UltimaCodes/salt-sentinel/larp.jpeg

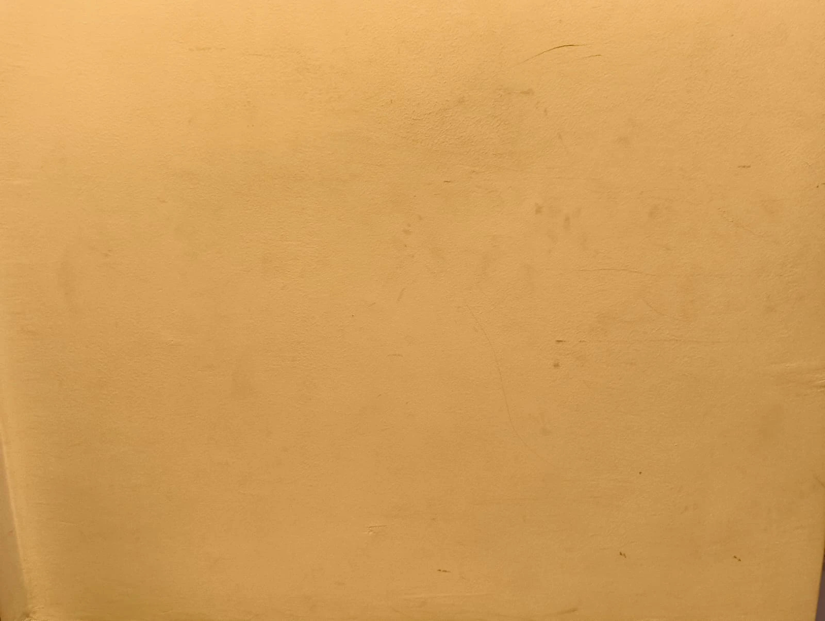
larp.jpeg
