UltimaCodes/salt-sentinel/TRELLO_CHECKLIST.txt

=======================================================
SALT SENTINEL - CHECKLIST  (rev 3 - post-build)
04 Sep  nationals
Paste each block into Trello as a list; one line = one card
=======================================================

Build and submission are done - this file only carries what's still ahead
of nationals. The full build-phase history (power tree, drivetrain,
sensor bring-up, calibration, validation wall) has been dropped; ask if
you need it back for the report's "challenges faced" section.

### PACK AND TRAVEL - WED 02 - THU 03 SEP ###
Build padded transport case for Lahore
Label every connector
Pack spares - motor, driver, ESP32, sensors, 3 spare cells, fuses
Print the report and any booth materials
Rehearse Q&A - be ready to answer AI usage questions out loud
Travel to Lahore

### DO NOT REGRESS ON - REFERENCE CARD ###
Never propose contact-based sensing - C1 is non-negotiable
Do not re-add EMI sensing - dry salt is non-conductive, specificity not earliness
Ultrasonic only for close-range standoff, never for mapping
Do not present [E] estimates as data
Standoff CONSISTENCY matters more than closeness
Dawn patrols, not midday - thermal signal inverts on sun-baked walls
Tag every reading with pass mode, conditions, dew point margin, dust flag
Thermal pass at ~1m so the frame has a dry reference, camera pass at ~25cm
LEDs fire one at a time, always
Never re-run calib-camera between visits
