UltimaCodes/salt-sentinel/schematics_final/salt_sentinel.pdf

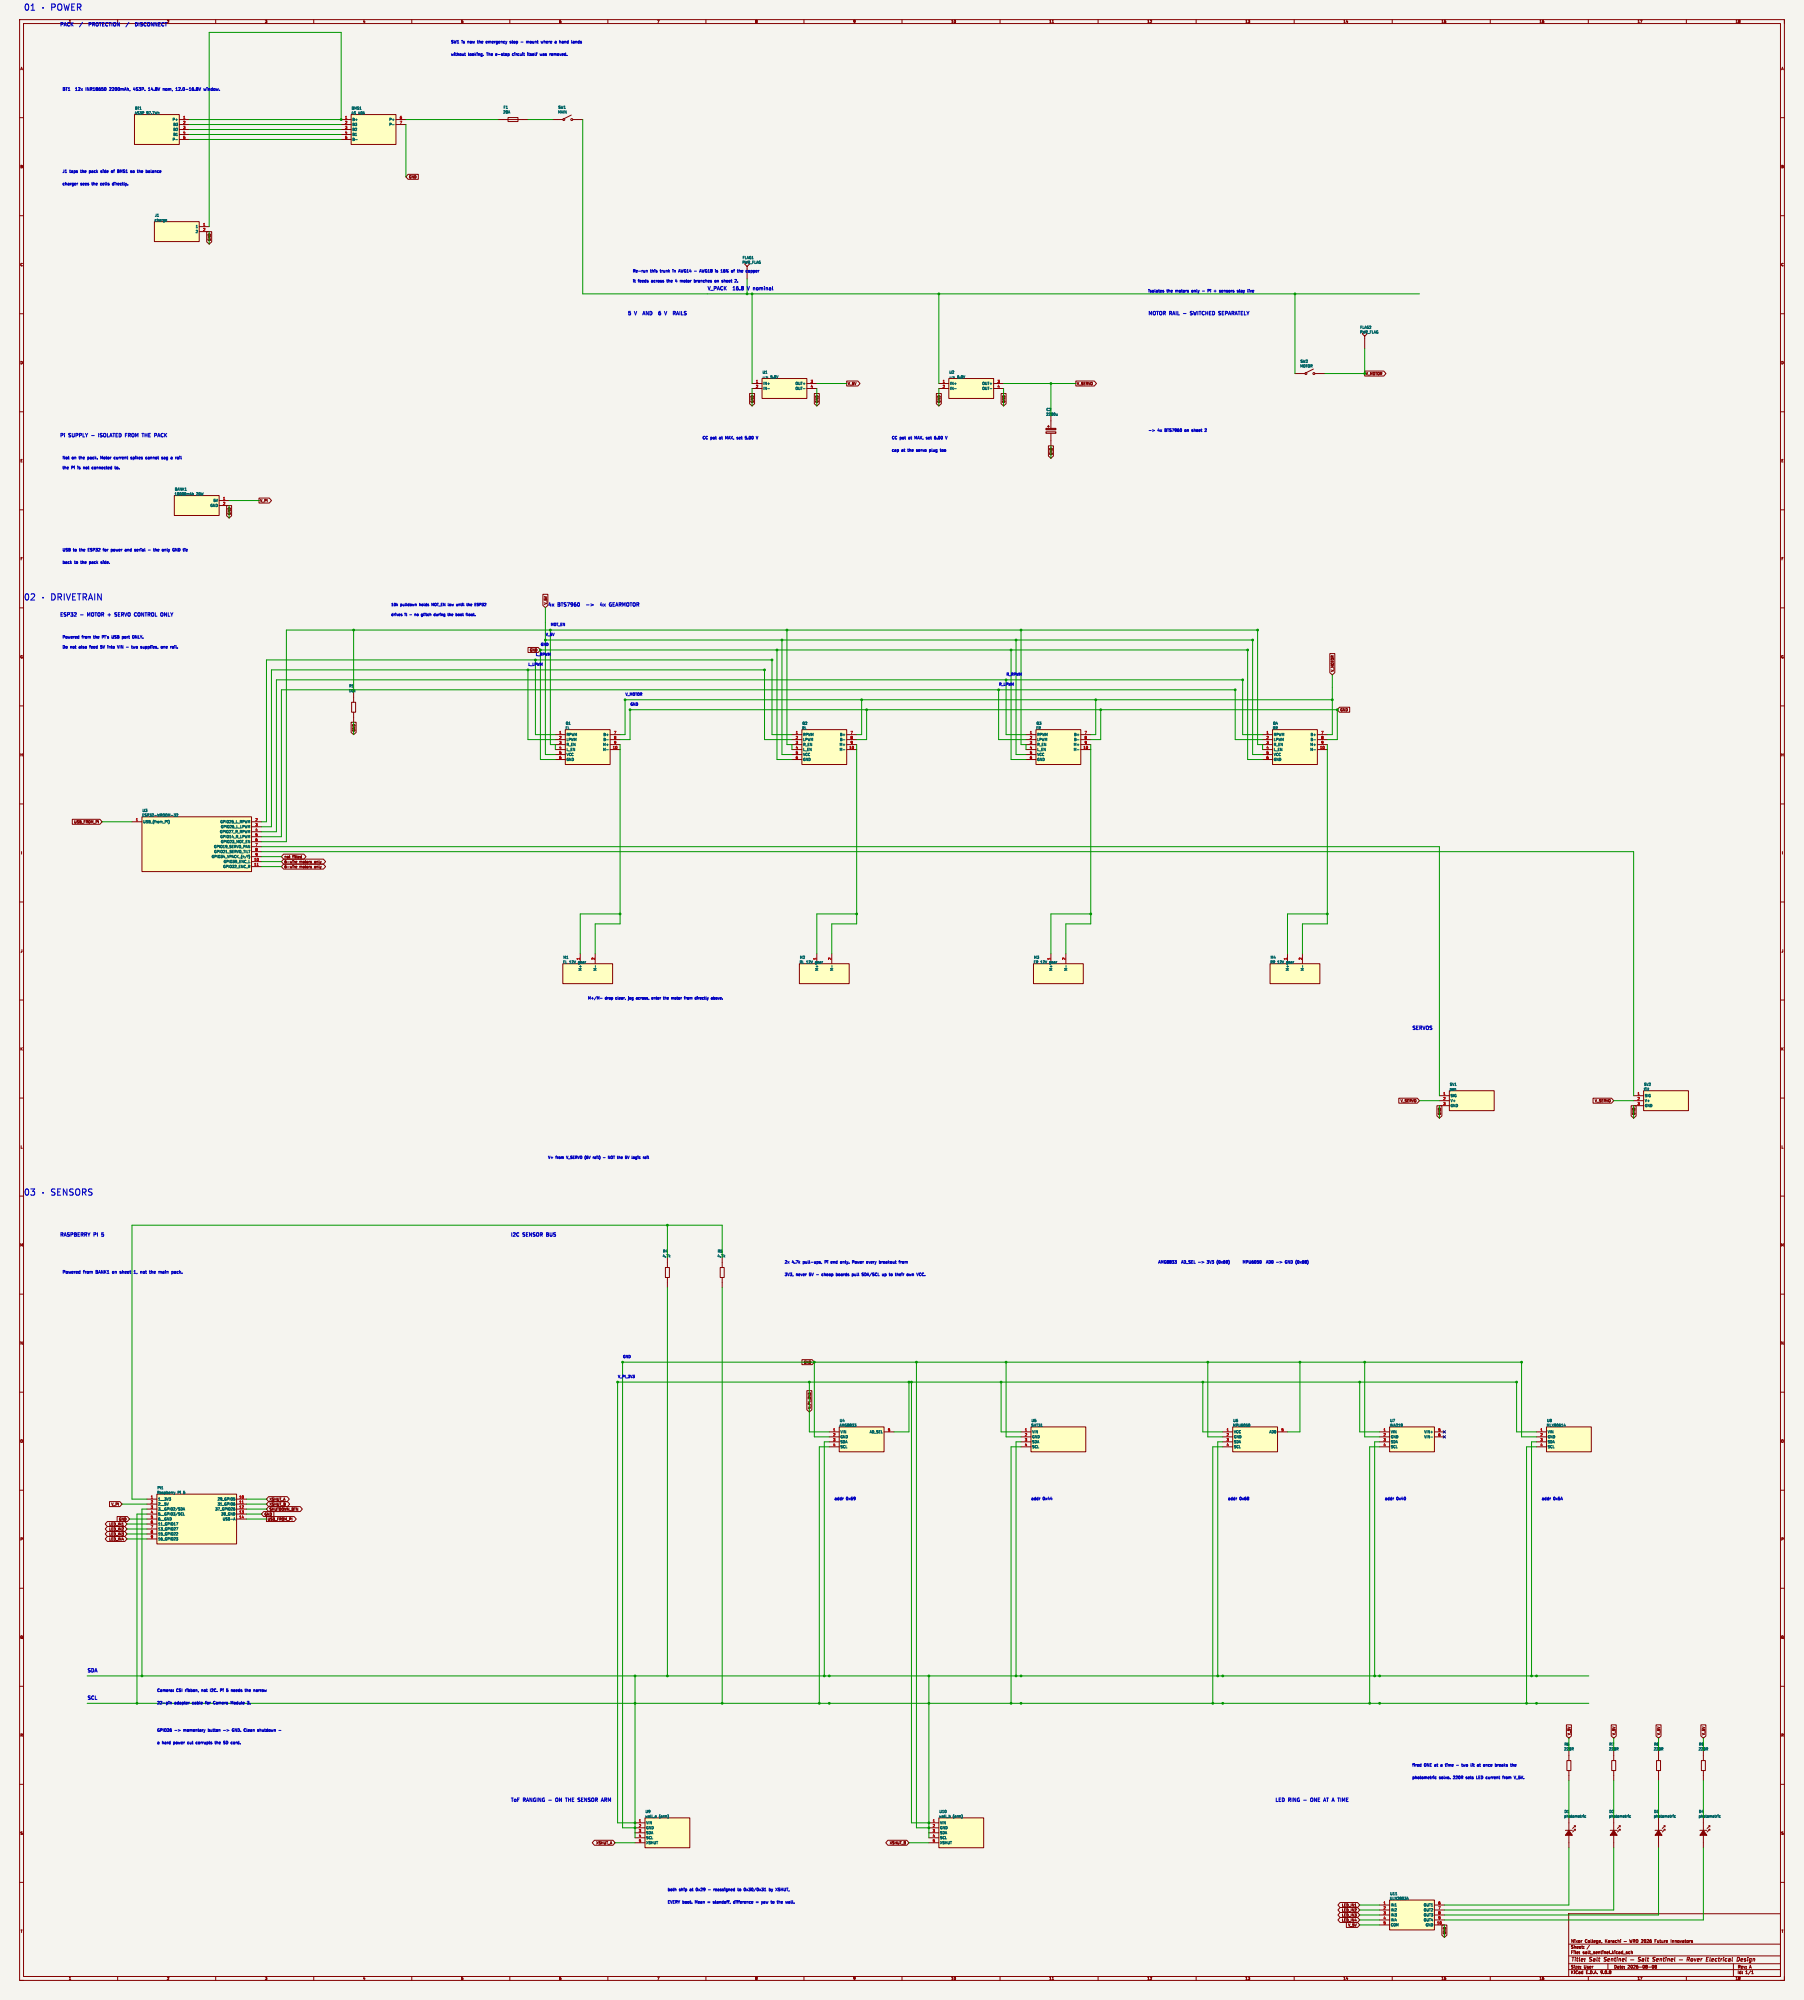
[picture p2: page 1]

J1 taps the pack side of BMS1 so the balance

charger sees the cells directly.

MOTOR RAIL - SWITCHED SEPARATELY

Pi SUPPLY - ISOLATED FROM THE PACK

CC pot at MAX, set 5.00 V

cap at the servo plug too CC pot at MAX, set 6.00 V

USB to the ESP32 for power and serial - the only GND tie

back to the pack side.

ESP32 - MOTOR + SERVO CONTROL ONLY

Powered from the Pi's USB port ONLY.

3V3, never 5V - cheap boards pull SDA/SCL up to their own VCC. V+ from V_SERVO (6V rail) - NOT the 5V logic rail

Camera: CSI ribbon, not I2C. Pi 5 needs the narrow

fired ONE at a time - two lit at once breaks the

LED RING - ONE AT A TIME

Id: 1/1 Title: Salt Sentinel þÿ Salt Sentinel þÿ Rover Electrical Design
