UltimaCodes/salt-sentinel/schematics_final/salt_sentinel.kicad_sch

## KiCad design schematics_final/salt_sentinel.kicad_sch (2026-08-31)

Schematic: salt_sentinel.kicad_sch

Parts:
BANK1: 10000mAh 20W
BMS1: 4S 40A
BT1: 4S3P 97.7Wh
C2: 2200u
D1, D2, D3, D4: photometric
F1: 20A
FLAG1, FLAG2: PWR_FLAG
J1: charge
M1: FL 12V gear
M2: RL 12V gear
M3: FR 12V gear
M4: RR 12V gear
PI1: Raspberry Pi 5
Q1: FL
Q2: RL
Q3: FR
Q4: RR
R1: 10k
R4, R5: 4.7k
R6, R7, R8, R9: 220R
SV1: pan
SV2: tilt
SW1: MAIN
SW2: MOTOR
U1: -> 5.0V
U2: -> 6.0V
U3: ESP32-WROOM-32
U4: AMG8833
U5: SHT31
U6: MPU6050
U7: INA219
U8: MLX90614
U9: wall_a (arm)
U10: wall_b (arm)
U11: ULN2803A

Connections:
6-wire motors only: U3.10 (GPIO39_ENC_L), U3.11 (GPIO32_ENC_R)
GND: BANK1.2 (GND), BMS1.7 (P-), C2.2, J1.2, PI1.3 (3__GPIO2/SDA), PI1.4 (5__GPIO3/SCL), PI1.5 (6__GND), PI1.13 (39_GND), Q1.6 (GND), Q1.8 (B-), Q2.6 (GND), Q2.8 (B-), Q3.6 (GND), Q3.8 (B-), Q4.6 (GND), Q4.8 (B-), R1.2, R4.2, R5.2, SV1.3 (GND), SV2.3 (GND), U1.2 (IN-), U1.4 (OUT-), U2.2 (IN-), U2.4 (OUT-), U4.1 (VIN), U4.2 (GND), U4.3 (SDA), U4.4 (SCL), U4.5 (AD_SEL), U5.1 (VIN), U5.2 (GND), U5.3 (SDA), U5.4 (SCL), U6.1 (VCC), U6.2 (GND), U6.3 (SDA), U6.4 (SCL), U6.5 (AD0), U7.1 (VIN), U7.2 (GND), U7.3 (SDA), U7.4 (SCL), U8.1 (VIN), U8.2 (GND), U8.3 (SDA), U8.4 (SCL), U9.1 (VIN), U9.2 (GND), U9.3 (SDA), U9.4 (SCL), U10.1 (VIN), U10.2 (GND), U10.3 (SDA), U10.4 (SCL), U11.10 (GND)
LED_IN1: PI1.6 (11_GPIO17), U11.1 (IN1)
LED_IN2: PI1.7 (13_GPIO27), U11.2 (IN2)
LED_IN3: PI1.8 (15_GPIO22), U11.3 (IN3)
LED_IN4: PI1.9 (16_GPIO23), U11.4 (IN4)
unnamed: BMS1.1 (B+), BT1.1 (P+), J1.1
unnamed: BMS1.2 (B3), BT1.2 (B3)
unnamed: BMS1.3 (B2), BT1.3 (B2)
unnamed: BMS1.4 (B1), BT1.4 (B1)
unnamed: BMS1.5 (B-), BT1.5 (P-)
unnamed: BMS1.6 (P+), F1.1
unnamed: D1.1 (A), R6.2
unnamed: D1.2 (K), U11.6 (OUT1)
unnamed: D2.1 (A), R7.2
unnamed: D2.2 (K), U11.7 (OUT2)
unnamed: D3.1 (A), R8.2
unnamed: D3.2 (K), U11.8 (OUT3)
unnamed: D4.1 (A), R9.2
unnamed: D4.2 (K), U11.9 (OUT4)
unnamed: F1.2, SW1.1
unnamed: FLAG1.1, SW1.2, SW2.1, U1.1 (IN+), U2.1 (IN+)
unnamed: M1.1 (M+), M1.2 (M-), Q1.9 (M+), Q1.10 (M-)
unnamed: M2.1 (M+), M2.2 (M-), Q2.9 (M+), Q2.10 (M-)
unnamed: M3.1 (M+), M3.2 (M-), Q3.9 (M+), Q3.10 (M-)
unnamed: M4.1 (M+), M4.2 (M-), Q4.9 (M+), Q4.10 (M-)
unnamed: PI1.1 (1__3V3), R4.1, R5.1
unnamed: Q1.1 (RPWM), Q2.1 (RPWM), U3.2 (GPIO25_L_RPWM)
unnamed: Q1.2 (LPWM), Q2.2 (LPWM), U3.3 (GPIO26_L_LPWM)
unnamed: Q1.3 (R_EN), Q1.4 (L_EN), Q2.3 (R_EN), Q2.4 (L_EN), Q3.3 (R_EN), Q3.4 (L_EN), Q4.3 (R_EN), Q4.4 (L_EN), R1.1, U3.6 (GPIO23_MOT_EN)
unnamed: Q3.1 (RPWM), Q4.1 (RPWM), U3.4 (GPIO27_R_RPWM)
unnamed: Q3.2 (LPWM), Q4.2 (LPWM), U3.5 (GPIO14_R_LPWM)
unnamed: SV1.1 (SIG), U3.7 (GPIO19_SERVO_PAN)
unnamed: SV2.1 (SIG), U3.8 (GPIO21_SERVO_TILT)
SHUTDOWN_BTN: PI1.12 (37_GPIO26)
USB_FROM_PI: PI1.14 (USB-A), U3.1 (USB_(from_Pi))
V_5V: Q1.5 (VCC), Q2.5 (VCC), Q3.5 (VCC), Q4.5 (VCC), R6.1, R7.1, R8.1, R9.1, U1.3 (OUT+), U11.5 (COM)
V_MOTOR: FLAG2.1, Q1.7 (B+), Q2.7 (B+), Q3.7 (B+), Q4.7 (B+), SW2.2
V_PI: BANK1.1 (5V), PI1.2 (2__5V)
V_SERVO: C2.1, SV1.2 (V+), SV2.2 (V+), U2.3 (OUT+)
XSHUT_A: PI1.10 (29_GPIO5), U9.5 (XSHUT)
XSHUT_B: PI1.11 (31_GPIO6), U10.5 (XSHUT)
not fitted: U3.9 (GPIO34_VPACK_(n/f))

Notes on the sheet:
V_PI_3V3
addr 0x5A
charger sees the cells directly.
addr 0x44
V_MOTOR
LED RING - ONE AT A TIME
GND
V_5V
fired ONE at a time - two lit at once breaks the
MOTOR RAIL - SWITCHED SEPARATELY
SDA
SERVOS
V+ from V_SERVO (6V rail) - NOT the 5V logic rail
J1 taps the pack side of BMS1 so the balance
I2C SENSOR BUS
2x 4.7k pull-ups, Pi end only. Power every breakout from
L_LPWM
CC pot at MAX, set 5.00 V
addr 0x69
MOT_EN
V_PACK 16.8 V nominal
Do not also feed 5V into VIN - two supplies, one rail.
BT1 12x INR18650 2200mAh, 4S3P. 14.8V nom, 12.0-16.8V window.
addr 0x40
3V3, never 5V - cheap boards pull SDA/SCL up to their own VCC.
Not on the pack. Motor current spikes cannot sag a rail
Camera: CSI ribbon, not I2C. Pi 5 needs the narrow
R_RPWM
10k pulldown holds MOT_EN low until the ESP32
USB to the ESP32 for power and serial - the only GND tie
01 · POWER
drives it - no glitch during the boot float.
SW1 is now the emergency stop - mount where a hand lands
isolates the motors only - Pi + sensors stay live
EVERY boot. Mean = standoff, difference = yaw to the wall.
AMG8833 AD_SEL -> 3V3 (0x69) MPU6050 AD0 -> GND (0x68)
M+/M- drop clear, jog across, enter the motor from directly above.
without looking. The e-stop circuit itself was removed.
L_RPWM
PACK / PROTECTION / DISCONNECT
02 · DRIVETRAIN
4x BTS7960 -> 4x GEARMOTOR
Pi SUPPLY - ISOLATED FROM THE PACK
5 V AND 6 V RAILS
Powered from the Pi's USB port ONLY.
addr 0x68
CC pot at MAX, set 6.00 V
photometric solve. 220R sets LED current from V_5V.
the Pi is not connected to.
back to the pack side.
22-pin adapter cable for Camera Module 3.
ESP32 - MOTOR + SERVO CONTROL ONLY
03 · SENSORS
GPIO26 -> momentary button -> GND. Clean shutdown -
RASPBERRY PI 5
cap at the servo plug too
both ship at 0x29 - reassigned to 0x30/0x31 by XSHUT,
it feeds across the 4 motor branches on sheet 2.
-> 4x BTS7960 on sheet 2
R_LPWM
Powered from BANK1 on sheet 1, not the main pack.
SCL
Re-run this trunk in AWG14 - AWG18 is 16% of the copper
ToF RANGING - ON THE SENSOR ARM
a hard power cut corrupts the SD card.
