UltimaCodes/salt-sentinel/(commit log)

2026-08-31 Initial commit: Salt Sentinel project snapshot
    Rover software (Pi + ESP32), KiCad schematics, WRO report/video assets,
    and planning docs as of the 25 Aug submission push.
    [01_power.kicad_sch, 02_drivetrain.kicad_sch, 03_sensors.kicad_sch, salt_sentinel.kicad_sch]
2026-09-02 Simplify drive firmware, add manual Ctrl+C stop, clean up docs
    Firmware (rev 4): drop encoder support (2-wire motors have nothing to
    read), remove the voltage-divider duty cap now that the motor rail is a
    regulated 7.2V buck, rename the Bluetooth override device to
    "thepretender". Document the wall_a/wall_b front/back assignment in
    config.py, derived from the existing steering sign convention rather
    than guessed.
    patrol.py: replace the camera-cover-based pause/end-of-wall signal with
    a plain Ctrl+C handler that still stops the motors and saves whatever
    was captured - keeps manual control CLI-only.
    Docs: remove the first-time-setup guide, the wiring build manual, and
    the two docs tied to th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
    [01_power.kicad_sch, 02_drivetrain.kicad_sch, 03_sensors.kicad_sch, salt_sentinel.kicad_sch]
2026-09-02 Fix real bugs surfaced by on-device testing, correct LED-ring claims
    Found by actually running cli.py on the Pi with only the camera wired:
    - calib-camera crashed (TypeError) on the fixed-focus OV5647 because it
    unconditionally formatted lens_position, which is None on any sensor
    without software AF - exactly the camera that's fitted.
    - --sim only worked before the subcommand despite the module docstring
    claiming "anywhere"; argparse subparsers were silently resetting it
    back to False when passed after. Fixed properly (each parser gets its
    own --sim with a SUPPRESS default - sharing one parent parser object
    across subparsers turned out to corrupt that default).
    Also: the LED fi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
    [cli.py, config.py, leds.py, report_pdf.py]
2026-09-02 Fix station command not saving, and USB backup finding nothing
    cmd_station computed a reading, printed it, and printed store.dir as
    if the reading had been saved there - but never called store.append(),
    so the folder it reported was always empty. Now builds a real
    StationRecord and calls append() + finalize(), same as patrol/demo do.
    Store._usb_mounts() only scanned /media/<user>/<label>, which assumes
    a desktop session's automount service already reacted to the drive
    being plugged in. True if someone's physically logged into the Pi's
    desktop or on VNC; false over Remote Pi's shell with nobody at the
    console, which is how this rig is actually being driven - nothing
    mounts the drive in that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
    [cli.py, store.py]
2026-09-02 Remove synthetic demo pipeline, wire real CSV/heatmap/PDF into station+patrol
    The demo command generated a staged/fake patrol and ran it through the
    report pipeline, since real data wasn't available yet during the build
    phase. That's no longer true - remove demo_scenario.py, cmd_demo, and
    the old DEMO_run_* output folders, and instead wire the same CSV +
    wall-panorama-heatmap + PDF condition report into the real commands:
    - station now captures a real photo (when a camera is fitted) and
    writes csv/heatmap/pdf for that single reading before finalizing.
    - patrol saves one real photo per far pass (ambient light - no LED
    ring fitted), then at the end re-scores every captured station as
    on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
    [cli.py, patrol.py, report_pdf.py, risk.py, store.py]
2026-09-02 Require a real thermal gradient to flag, not a single hot/cold pixel
    Checked this against how professional building thermography actually
    guards against false positives: a lone anomalous reading isn't enough
    on its own, it has to show the right spatial shape - here, a genuine
    dry-then-suddenly-cooler transition. thermal.analyse() already computes
    exactly that (damp_row - the row with the single largest downward
    step) but nothing ever required it; flagging only checked whether the
    single hottest/coldest pixel crossed the threshold. A rock, a hand, or
    a sheet of plastic held in front of the sensor reads close to uniform
    across the frame and won't produce that shape even if it happens to be
    a d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
    [cli.py, config.py, patrol.py]
